runger1101001/roboesc_micro/ESCv4.3.kicad_pcb

## KiCad design ESCv4.3.kicad_pcb (2022-04-19)

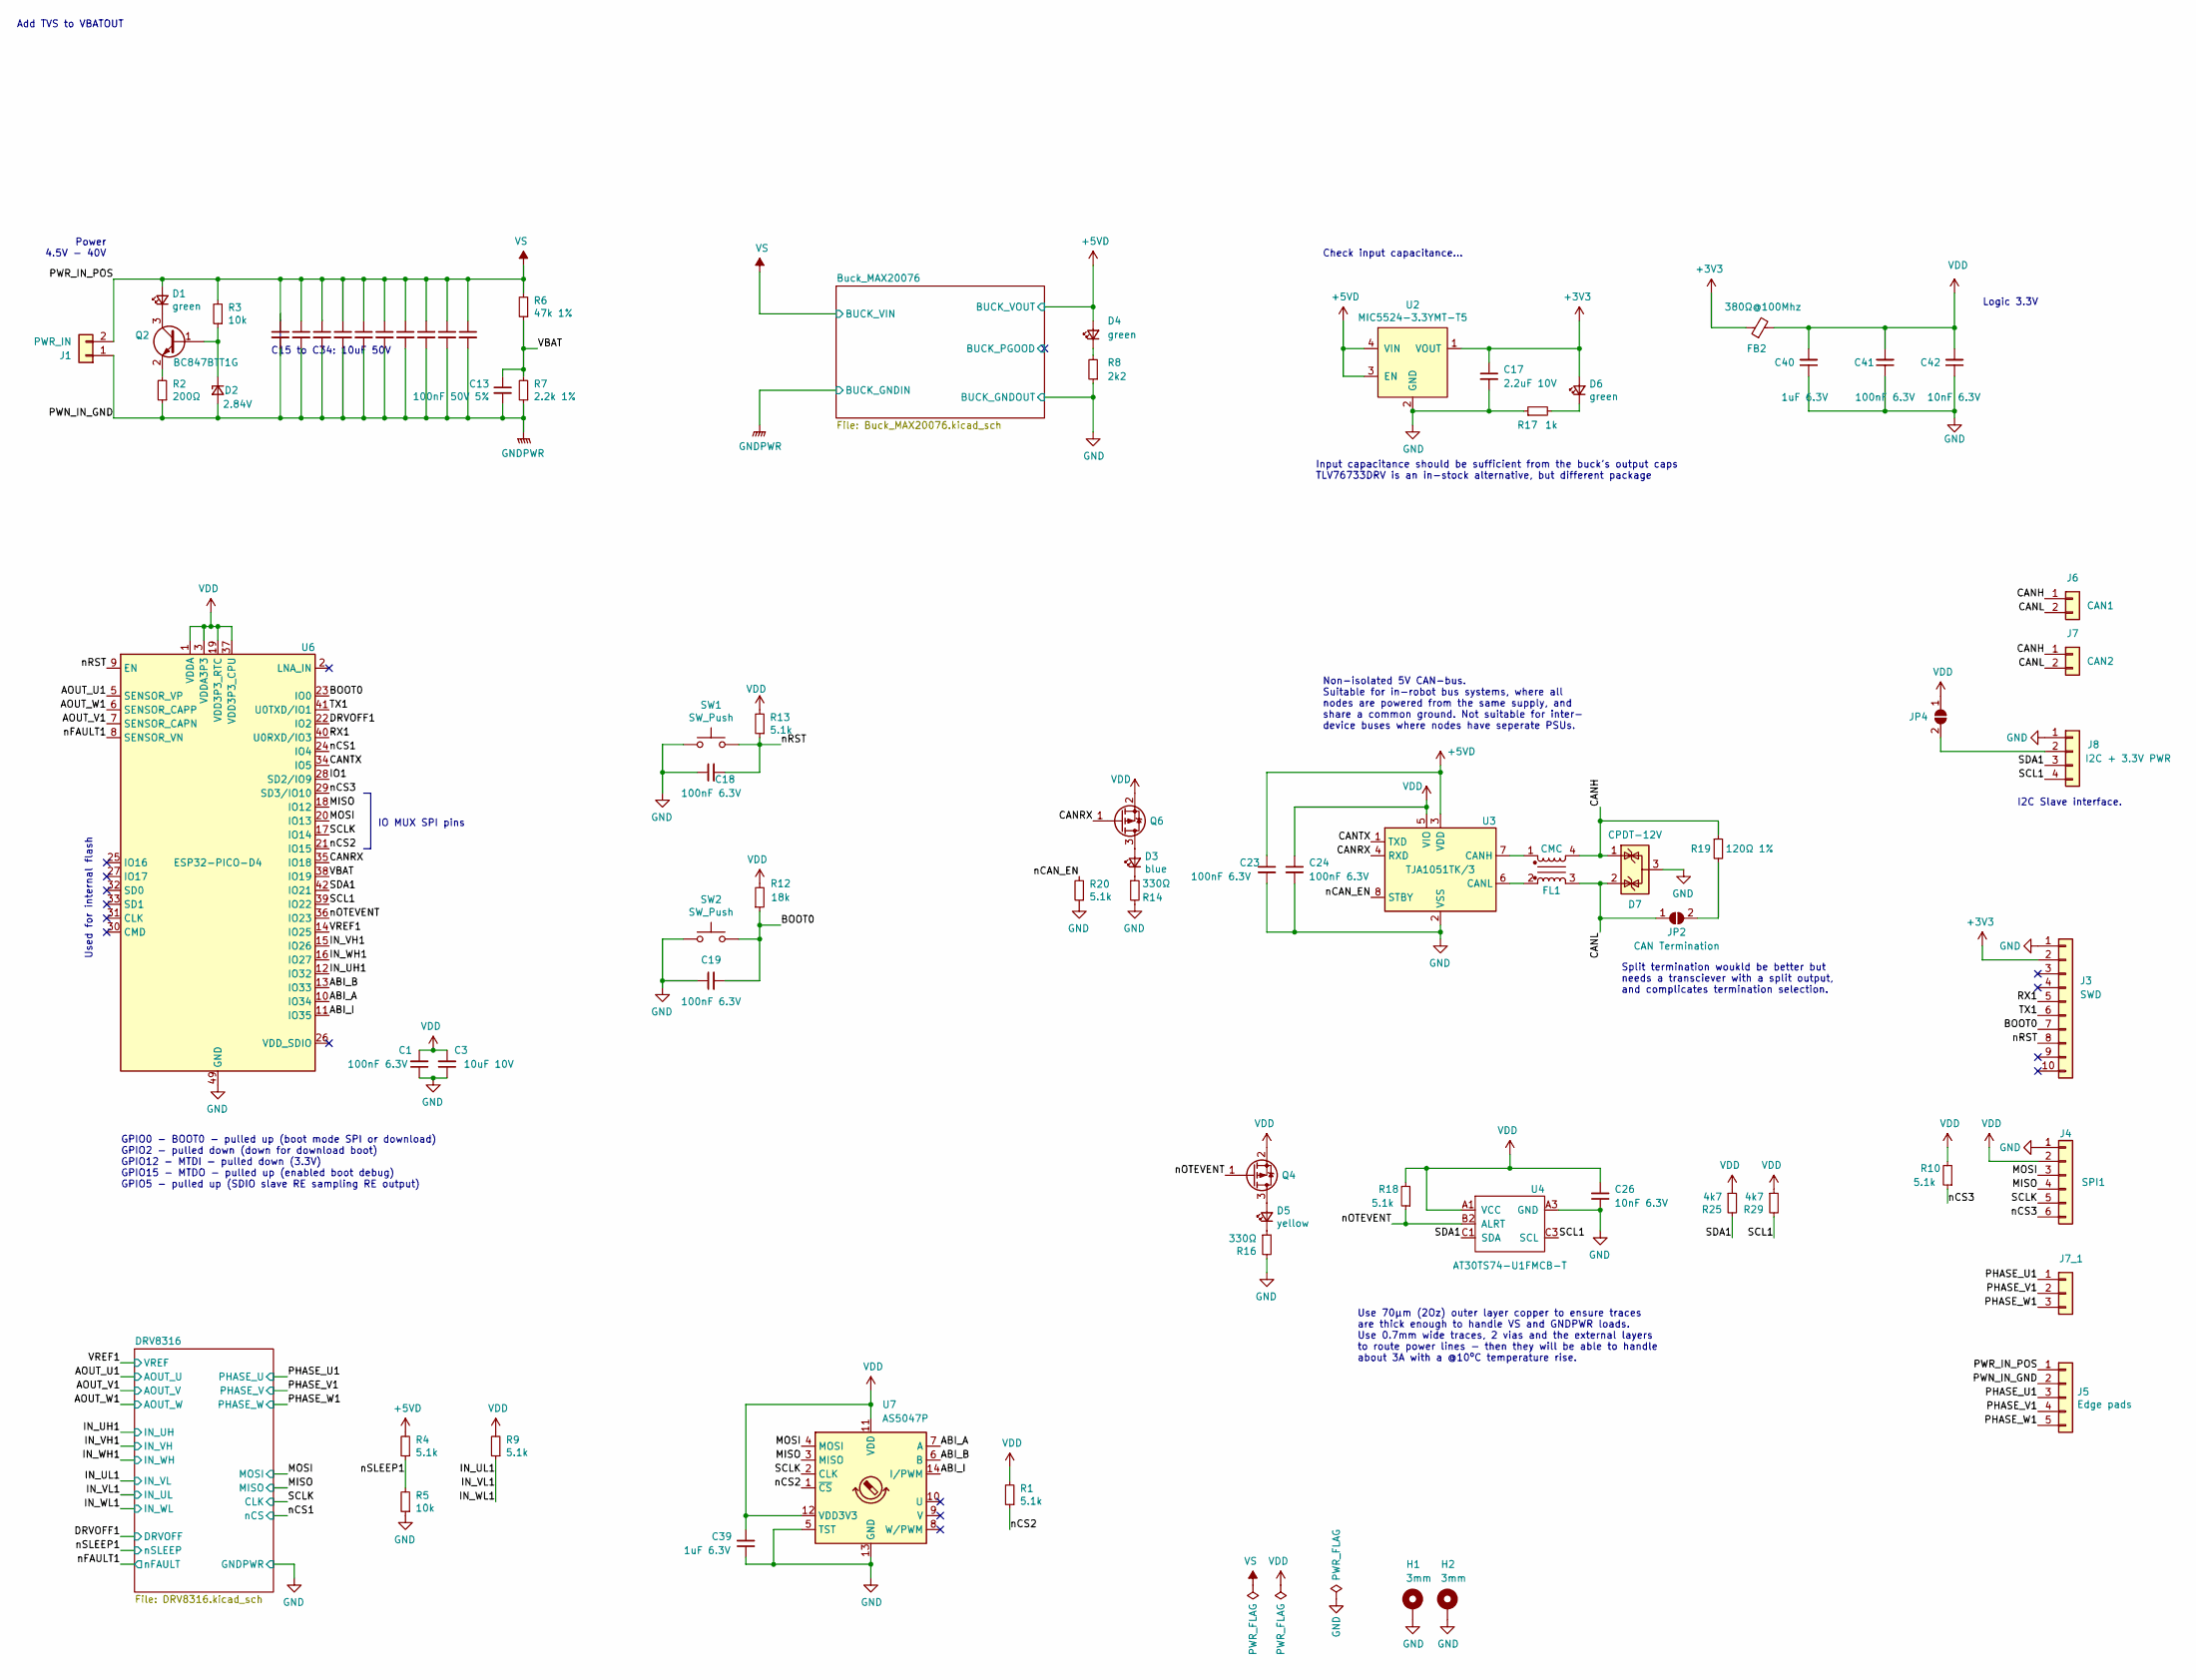
[picture p1: schematic ESCv4.3.kicad_sch]

Parts:
C1, C18, C19, C41: 100nF 6.3V; C_0402_1005Metric; Part CL05B104KQ5NNNC
C2, C4, C5, C6, C7, C8, C9, C10, C11, C12: 10uF 50V; C_0805_2012Metric; Part GRM21BR61H106KE43L
C3: 10uF 10V; C_0402_1005Metric; Part ZRB15XR61A106ME01D
C13: 100nF 50V 5%; C_0402_1005Metric; Part GRM155C71H104JE19D
C17: 2.2uF 10V; C_0603_1608Metric; Part GRM188R71A225KE15D
C23, C24: 100nF 6.3V; C_0402_1005Metric
C26, C42: 10nF 6.3V; C_0402_1005Metric; Part CC0402KRX7R5BB103
C39, C40: 1uF 6.3V; C_0402_1005Metric; Part GRT155C80J105KE01D
D1, D4, D6: green; LED_0402_1005Metric; Part SML-P12MTT86
D2: 2.84V; D_SOD-523; Part CZRU52C2V7-HF
D3: blue; LED_0402_1005Metric; Part LB QH9G-N1OO-35-1
D5: yellow; LED_0402_1005Metric; Part SML-P12YTT86RR
D7: CPDT-12V; SOT-23; Part CPDT-12V
FB2: 380Ω@100Mhz; L_0603_1608Metric; Part BLM18DN381SH1D
FL1: CMC; CMC_Filter_0504; Part KCZ1210AH900HRTD25
H1, H2: 3mm; MountingHole_2.2mm_M2_Pad_Via
J1: PWR_IN; AMASS_XT30UPB-M_1x02_P5.0mm_Vertical
J3: Conn_01x10; SAMTEC_SEI-110_Mating
J4: SPI1; JST_SH_BM06B-SRSS-TB_1x06-1MP_P1.00mm_Vertical; Part JST_SH_BM06B-SRSS-TB_1x06-1MP
J5: Conn_01x05; Motor_Power_Pads_CircleEdge40mm
J6: CAN1; JST_PH_B2B-PH-K_1x02_P2.00mm_Vertical; Part JST_PH_B2B-PH-K_1x02_P2.00mm_Vertical
J7: CAN2; JST_PH_B2B-PH-K_1x02_P2.00mm_Vertical; Part JST_PH_B2B-PH-K_1x02_P2.00mm_Vertical
J7_1: Phase_Pads; PinHeader_1x03_P2.54mm_Vertical
J8: Conn_01x04; JST_SH_BM04B-SRSS-TB_1x04-1MP_P1.00mm_Vertical; Part JST_SH_BM04B-SRSS-TB_1x04-1MP
JP2: CAN Termination; SolderJumper-2_P1.3mm_Open_TrianglePad1.0x1.5mm
JP4: SolderJumper_2_Open; SolderJumper-2_P1.3mm_Open_TrianglePad1.0x1.5mm
Q2: BC847BTT1G; SOT-416; Part BC847BTT1G
Q4, Q6: CSD25501F3; FemtoFET_0.7x0.6_YJN3; Part CSD25501F3
R1, R4, R9, R10, R13, R18, R20: 5.1k; R_0402_1005Metric
R2: 200Ω; R_0402_1005Metric
R3, R5: 10k; R_0402_1005Metric
R6: 47k 1%; R_0402_1005Metric
R7: 2.2k 1%; R_0402_1005Metric
R8: 2k2; R_0402_1005Metric
R12: 18k; R_0402_1005Metric
R14, R16: 330Ω; R_0402_1005Metric
R17: 1k; R_0402_1005Metric
R19: 120Ω 1%; R_0402_1005Metric
R25, R29: 4k7; R_0402_1005Metric
SW1: SW_Push; NANOT240; Part USLPT2616CT2TR
SW2: SW_Push; NANOT240; Part NANOT240
U2: MIC5524-3.3YMT-T5; TDFN-4-1EP_1x1mm_P0.65mm_EP0.5x0.5mm; Part MIC5524-3.3YMT-T5
U3: TJA1051TK/3; DFN-8-1EP_3x3mm_P0.65mm_EP1.55x2.4mm; Part TJA1051TK/3
U4: AT30TS74-U1FMCB-T; Texas_DSBGA-5_0.822x1.116mm_Layout2x1x2_P0.4mm; Part AT30TS74-U1FMCB-T
U6: ESP32-PICO-D4; QFN-48-1EP_7x7mm_P0.5mm_EP5.3x5.3mm; Part ESP32-PICO-D4
U7: AS5047P; TSSOP-14_4.4x5mm_P0.65mm; Part AS5047P

Connections:
+3V3: C17.1, D6.2 (A), FB2.1, J3.2, U2.1 (VOUT); also elsewhere on the board
+5VD: C23.1, D4.2 (A), R4.2, U2.3 (EN), U2.4 (VIN), U3.3 (VDD); also elsewhere on the board
/ABI_A: U6.10 (IO34), U7.7 (A)
/ABI_B: U6.13 (IO33), U7.6 (B)
/ABI_I: U6.11 (IO35), U7.14 (I/PWM)
/AOUT_U1: U6.5 (SENSOR_VP); also elsewhere on the board
/AOUT_V1: U6.7 (SENSOR_CAPN); also elsewhere on the board
/AOUT_W1: U6.6 (SENSOR_CAPP); also elsewhere on the board
/BOOT0: C19.2, J3.7, R12.1, SW2.2, U6.23 (IO0); also elsewhere on the board
/CANH: D7.1 (K), FL1.4, J6.1, J7.1, R19.1
/CANL: D7.2 (K), FL1.3, J6.2, J7.2, JP2.1 (A)
/CANRX: Q6.1 (G), U3.4 (RXD), U6.35 (IO18)
/CANTX: U3.1 (TXD), U6.34 (IO5)
/DRVOFF1: U6.22 (IO2); also elsewhere on the board
/IN_UH1: U6.12 (IO32); also elsewhere on the board
/IN_UL1: R9.1; also elsewhere on the board
/IN_VH1: U6.15 (IO26); also elsewhere on the board
/IN_WH1: U6.16 (IO27); also elsewhere on the board
/IO1: U6.28 (SD2/IO9)
/MISO: J4.4, U6.18 (IO12), U7.3 (MISO); also elsewhere on the board
/MOSI: J4.3, U6.20 (IO13), U7.4 (MOSI); also elsewhere on the board
/PHASE_U1: J5.3, J7_1.1; also elsewhere on the board
/PHASE_V1: J5.4, J7_1.2; also elsewhere on the board
/PHASE_W1: J5.5, J7_1.3; also elsewhere on the board
/RX1: J3.5, U6.40 (U0RXD/IO3); also elsewhere on the board
/SCL1: J8.4, R29.2, U4.C3 (SCL), U6.39 (IO22)
/SCLK: J4.5, U6.17 (IO14), U7.2 (CLK); also elsewhere on the board
/SDA1: J8.3, R25.2, U4.C1 (SDA), U6.42 (IO21)
/TX1: J3.6, U6.41 (U0TXD/IO1); also elsewhere on the board
/VBAT: C13.1, R6.1, R7.2, U6.38 (IO19)
/VREF1: U6.14 (IO25); also elsewhere on the board
/nCAN_EN: R20.2, U3.8 (STBY)
/nCS1: U6.24 (IO4); also elsewhere on the board
/nCS2: R1.1, U6.21 (IO15), U7.1 (~CS)
/nCS3: J4.6, R10.1, U6.29 (SD3/IO10)
/nFAULT1: U6.8 (SENSOR_VN); also elsewhere on the board
/nOTEVENT: Q4.1 (G), R18.1, U4.B2 (ALRT), U6.36 (IO23)
/nRST: C18.2, J3.8, R13.1, SW1.2, U6.9 (EN); also elsewhere on the board
/nSLEEP1: R4.1, R5.2; also elsewhere on the board
unnamed: D1.1 (K), Q2.3 (C)
unnamed: D2.1 (K), Q2.1 (B), R3.1
unnamed: D3.1 (K), R14.1
unnamed: D3.2 (A), Q6.3 (D)
unnamed: D4.1 (K), R8.2
unnamed: D5.1 (K), R16.1
unnamed: D5.2 (A), Q4.3 (D)
unnamed: D6.1 (K), R17.2
unnamed: FL1.1, U3.7 (CANH)
unnamed: FL1.2, U3.6 (CANL)
unnamed: J8.2, JP4.2 (B)
unnamed: JP2.2 (B), R19.2
unnamed: Q2.2 (E), R2.2
VS: C2.1, C4.1, C5.1, C6.1, C7.1, C8.1, C9.1, C10.1, C11.1, C12.1, D1.2 (A), J1.2, J5.1, R3.2, R6.2; also elsewhere on the board

Notes on the sheet:
Add TVS to VBATOUT
IO MUX SPI pins
Input capacitance should be sufficient from the buck’s output caps TLV76733DRV is an in-stock alternative, but different package
I2C Slave interface.
GPIO0 - BOOT0 - pulled up (boot mode SPI or download) GPIO2 - pulled down (down for download boot) GPIO12 - MTDI - pulled down (3.3V) GPIO15 - MTDO - pulled up (enabled boot debug) GPIO5 - pulled up (SDIO slave RE sampling RE output)
C15 to C34: 10uF 50V
Power 4.5V - 40V
Used for internal flash
Logic 3.3V
Check input capacitance…
Non-isolated 5V CAN-bus. Suitable for in-robot bus systems, where all nodes are powered from the same supply, and share a common ground. Not suitable for inter- device buses where nodes have seperate PSUs.
Split termination woukld be better but needs a transciever with a split output, and complicates termination selection.
Use 70µm (2Oz) outer layer copper to ensure traces are thick enough to handle VS and GNDPWR loads. Use 0.7mm wide traces, 2 vias and the external layers to route power lines - then they will be able to handle about 3A with a @10ºC temperature rise.

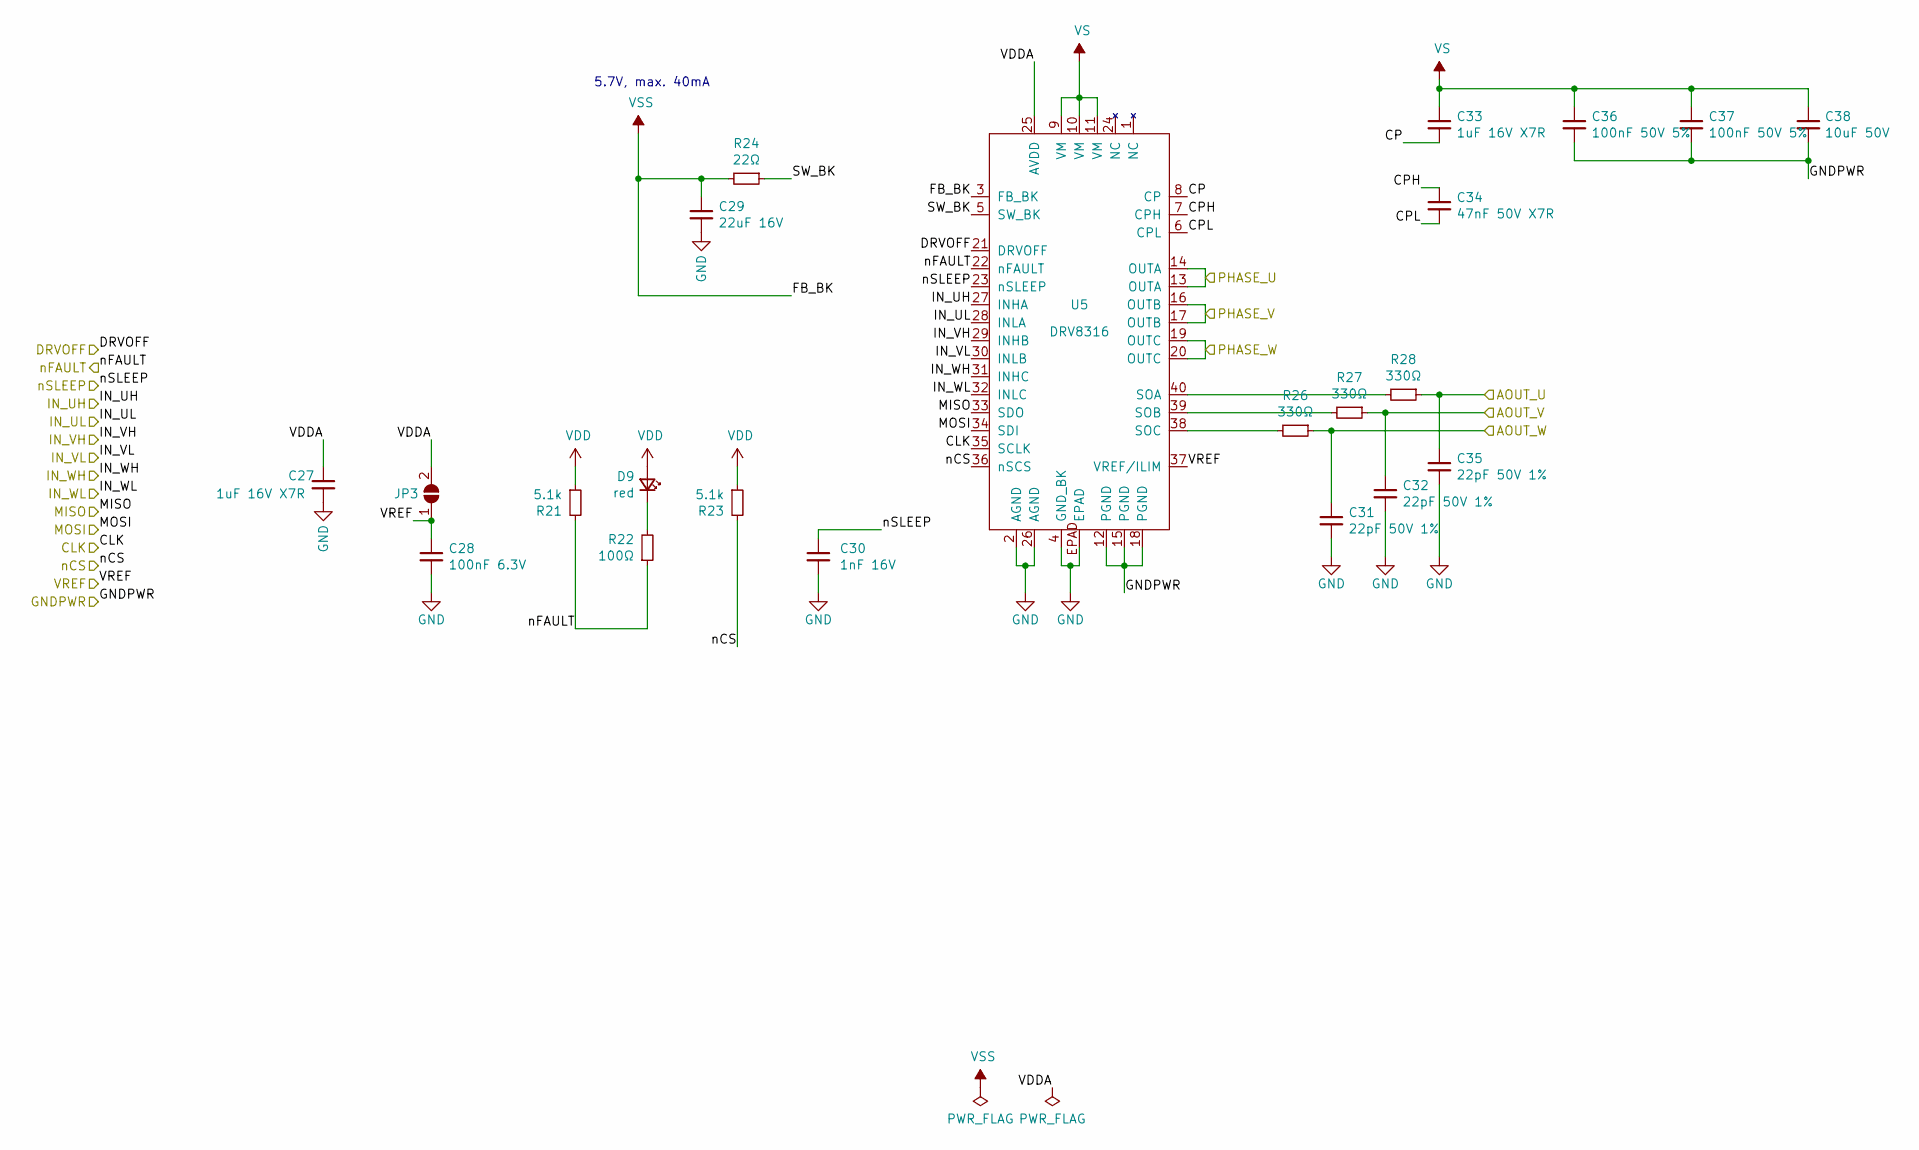
[picture p2: schematic DRV8316.kicad_sch]

Parts:
C27: 1uF 16V X7R; C_0402_1005Metric; Part 0603YC105JAT2A
C28: 100nF 6.3V; C_0402_1005Metric; Part CL05B104KQ5NNNC
C29: 22uF 16V; C_0805_2012Metric; Part GRM219R61C226ME15L
C30: 1nF 16V; C_0402_1005Metric; Part 0402YC102KAT2A
C31, C32, C35: 22pF 50V 1%; C_0402_1005Metric; Part GRM1555C1H220FA01D
C33: 1uF 16V X7R; C_0603_1608Metric; Part 0603YC105JAT2A
C34: 47nF 50V X7R; C_0402_1005Metric; Part GRM155R71H473KE14D
C36, C37: 100nF 50V 5%; C_0402_1005Metric; Part GRM155C71H104JE19D
C38: 10uF 50V; C_0805_2012Metric; Part GRM21BR61H106KE43L
D9: red; LED_0402_1005Metric; Part 150040RS73240
JP3: VSS2VDD; SolderJumper-2_P1.3mm_Open_TrianglePad1.0x1.5mm
R21, R23: 5.1k; R_0402_1005Metric
R22: 100Ω; R_0402_1005Metric
R24: 22Ω; R_0402_1005Metric
R26, R27, R28: 330Ω; R_0402_1005Metric
U5: DRV8316; vQFN-40_EP_5x7_Pitch0.5mm; Part DRV8316

Connections:
/AOUT_U1: C35.1, R28.1; also elsewhere on the board
/AOUT_V1: C32.1, R27.1; also elsewhere on the board
/AOUT_W1: C31.1, R26.1; also elsewhere on the board
/DRV8316/CP: C33.2, U5.8 (CP)
/DRV8316/CPH: C34.1, U5.7 (CPH)
/DRV8316/CPL: C34.2, U5.6 (CPL)
/DRV8316/SW_BK: R24.1, U5.5 (SW_BK)
/DRV8316/VDDA: C27.1, JP3.2 (B), U5.25 (AVDD)
/DRVOFF1: U5.21 (DRVOFF); also elsewhere on the board
/IN_UH1: U5.27 (INHA); also elsewhere on the board
/IN_UL1: U5.28 (INLA), U5.30 (INLB), U5.32 (INLC); also elsewhere on the board
/IN_VH1: U5.29 (INHB); also elsewhere on the board
/IN_WH1: U5.31 (INHC); also elsewhere on the board
/MISO: U5.33 (SDO); also elsewhere on the board
/MOSI: U5.34 (SDI); also elsewhere on the board
/PHASE_U1: U5.13 (OUTA), U5.14 (OUTA); also elsewhere on the board
/PHASE_V1: U5.16 (OUTB), U5.17 (OUTB); also elsewhere on the board
/PHASE_W1: U5.19 (OUTC), U5.20 (OUTC); also elsewhere on the board
/SCLK: U5.35 (SCLK); also elsewhere on the board
/VREF1: C28.1, JP3.1 (A), U5.37 (VREF/ILIM); also elsewhere on the board
/nCS1: R23.2, U5.36 (nSCS); also elsewhere on the board
/nFAULT1: R21.2, R22.1, U5.22 (nFAULT); also elsewhere on the board
/nSLEEP1: C30.1, U5.23 (nSLEEP); also elsewhere on the board
unnamed: D9.1 (K), R22.2
unnamed: R26.2, U5.38 (SOC)
unnamed: R27.2, U5.39 (SOB)
unnamed: R28.2, U5.40 (SOA)
VS: C33.1, C36.1, C37.1, C38.1, U5.9 (VM), U5.10 (VM), U5.11 (VM); also elsewhere on the board
VSS: C29.1, R24.2, U5.3 (FB_BK)

Notes on the sheet:
5.7V, max. 40mA

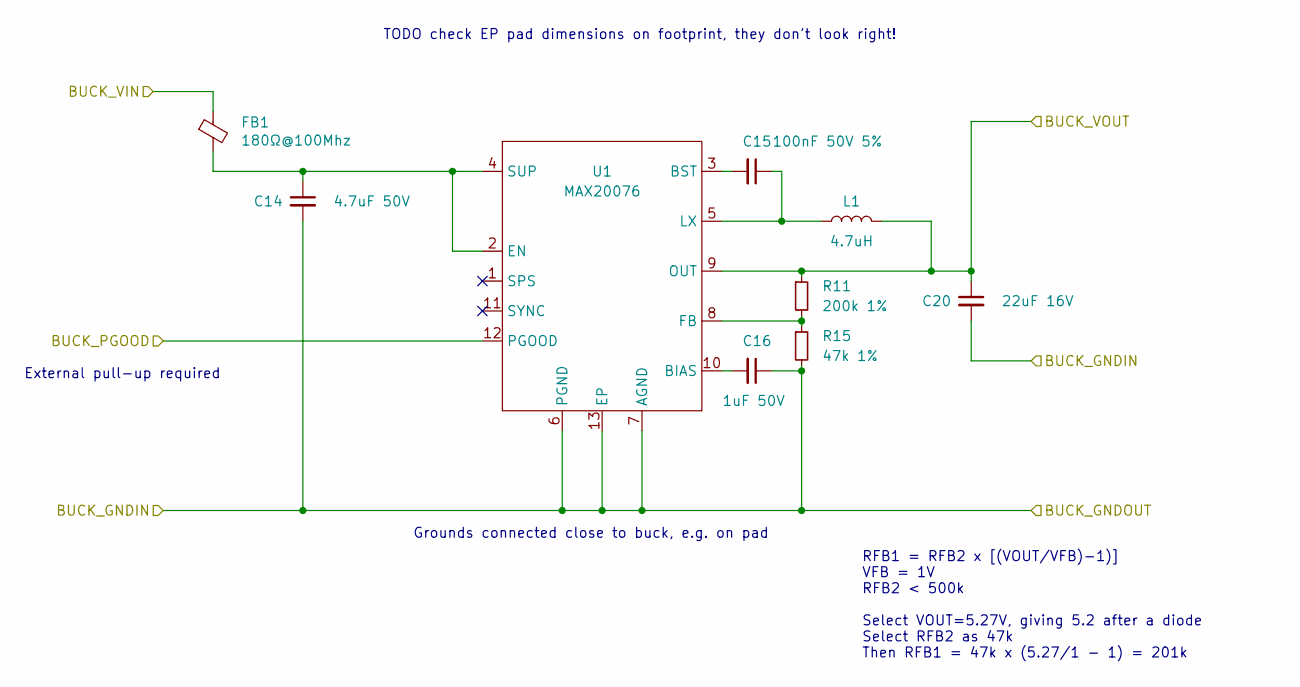
[picture p3: schematic Buck_MAX20076.kicad_sch]

Parts:
C14: 4.7uF 50V; C_0805_2012Metric; Part GRM21BZ71H475ME15K
C15: 100nF 50V 5%; C_0402_1005Metric; Part GRM155C71H104JE19D
C16: 1uF 50V; C_0402_1005Metric; Part GRM155R61H105KE05D
C20: 22uF 16V; C_0603_1608Metric; Part CL10A226MO7JZNC
FB1: 180Ω@100Mhz; L_0805_2012Metric; Part BLM21SP181SZ1D
L1: 4.7uH; L_Coilcraft_XxL4030; Part XAL4030-472MEC
R11: 200k 1%; R_0402_1005Metric; Part ERJ2RKD2003X
R15: 47k 1%; R_0402_1005Metric; Part TNPW040247K0BYEP
U1: MAX20076; DFN-12-1EP_3x3mm_P0.5mm_EP1.7x2.5mm; Part MAX20076EATCB/VY+

Connections:
+5VD: C20.1, L1.2, R11.1, U1.9 (OUT); also elsewhere on the board
/Buck_MAX20076/BUCK_PGOOD: U1.12 (PGOOD)
unnamed: C14.1, FB1.2, U1.2 (EN), U1.4 (SUP)
unnamed: C15.1, L1.1, U1.5 (LX)
unnamed: C15.2, U1.3 (BST)
unnamed: C16.2, U1.10 (BIAS)
unnamed: R11.2, R15.1, U1.8 (FB)
VS: FB1.1; also elsewhere on the board

Notes on the sheet:
TODO check EP pad dimensions on footprint, they don't look right!
Grounds connected close to buck, e.g. on pad
RFB1 = RFB2 x [(VOUT/VFB)-1)] VFB = 1V RFB2 < 500k Select VOUT=5.27V, giving 5.2 after a diode Select RFB2 as 47k Then RFB1 = 47k x (5.27/1 - 1) = 201k
External pull-up required

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
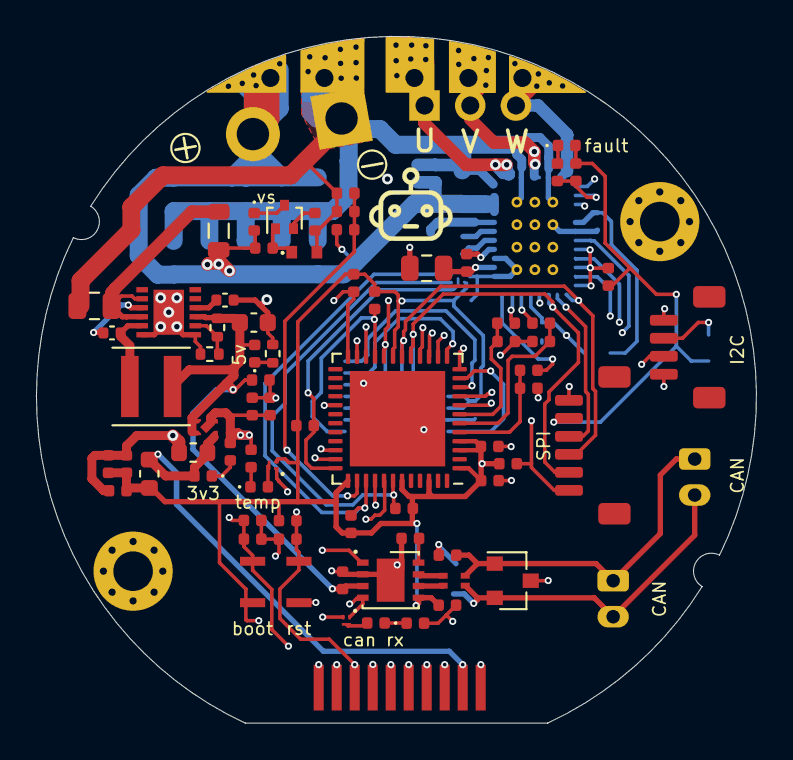
[picture p4: board ESCv4.3.kicad_pcb from above]

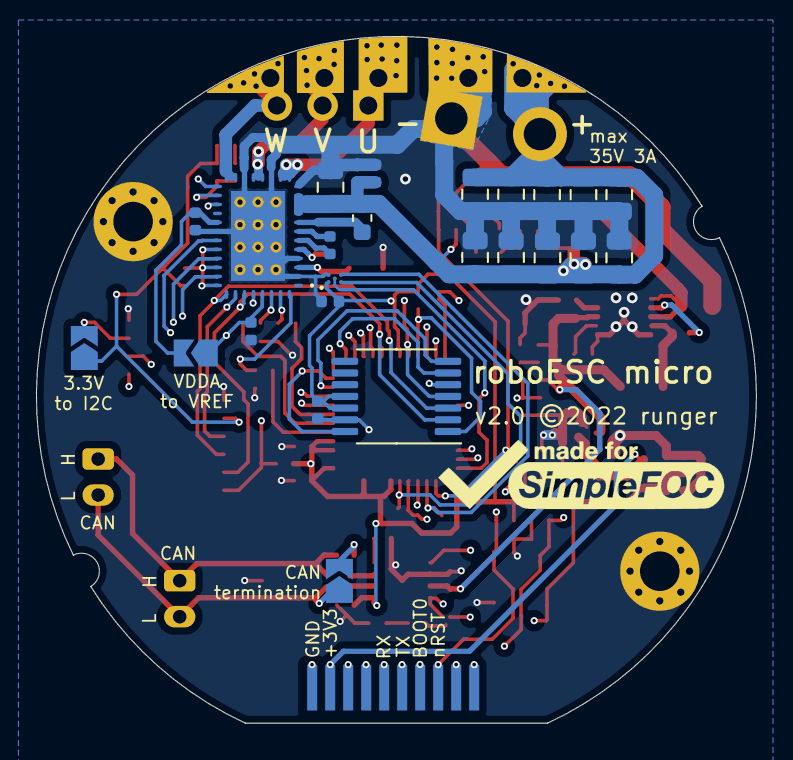
[picture p5: board ESCv4.3.kicad_pcb from below]

Board: 4 copper layers, 40.0 x 38.1 mm, 106 parts (26 on the bottom side), 69 nets.

Other parts of the board:
J3#2: Conn_01x10; SAMTEC_SEI-110_Mating

Their connections:
+3V3: J3#2.2; also elsewhere on the board
/BOOT0: J3#2.7; also elsewhere on the board
/RX1: J3#2.5; also elsewhere on the board
/TX1: J3#2.6; also elsewhere on the board
/nRST: J3#2.8; also elsewhere on the board
