runger1101001/roboesc_micro/(commit log)

2022-04-19 production version v1
    [Buck_MAX20076.kicad_sch, Buck_TPS63061.kicad_sch, DRV8316.kicad_sch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]
2022-04-19 add schematics PDF
