runger1101001/roboesc_micro/(notices)

Notices in the files:
ESCv4.3.kicad_pcb:
v2.0 ©2022 runger
